Andriustmp/RTKrobot/docs/Project principle diagram.png

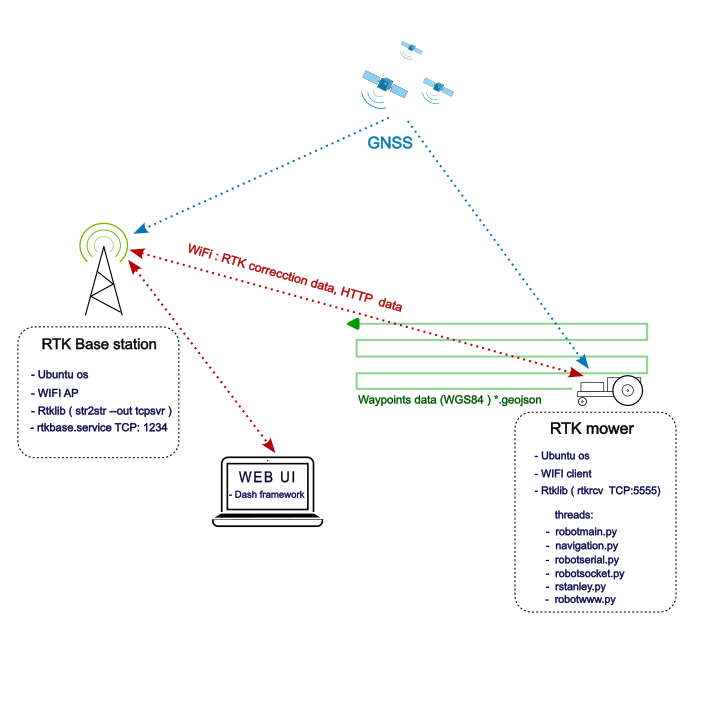
docs/Project principle diagram.png
