Andriustmp/RTKrobot/docs/RTKmower  WebUI.png

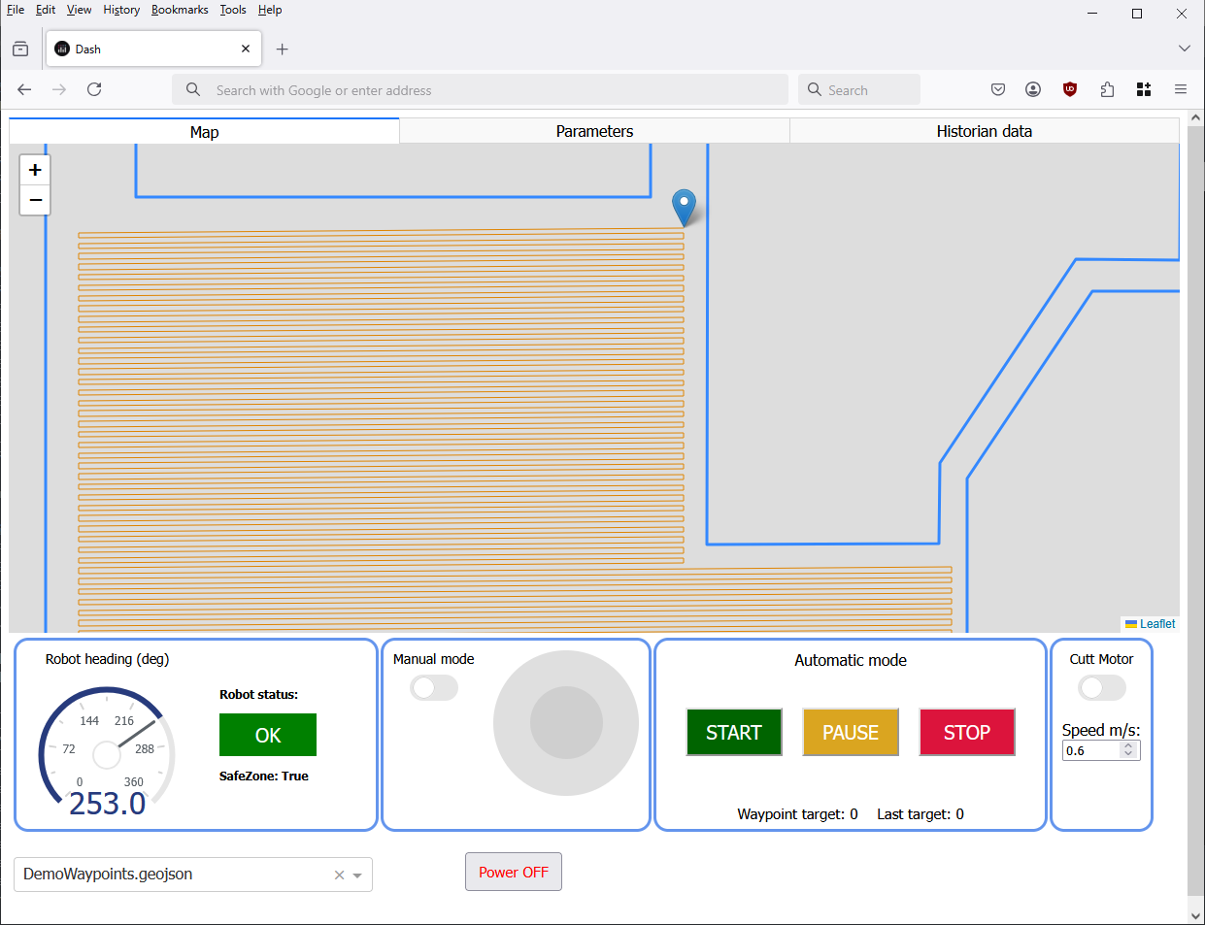
docs/RTKmower WebUI.png
