Andriustmp/RTKrobot/docs/RTKmower Components.png

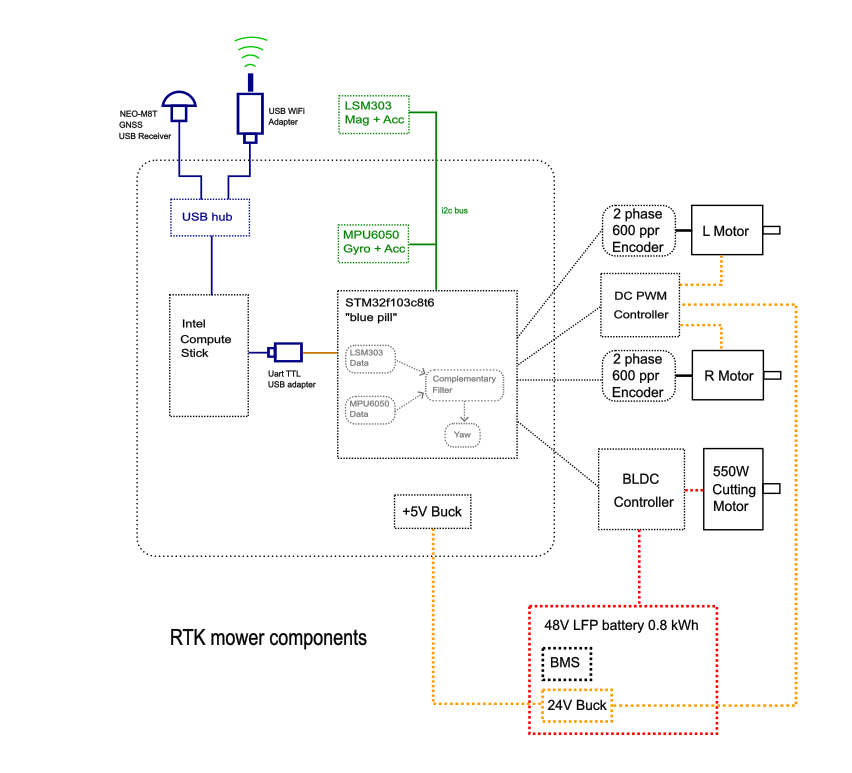
docs/RTKmower Components.png
