Andriustmp/RTKrobot/docs/Debug data sample.png

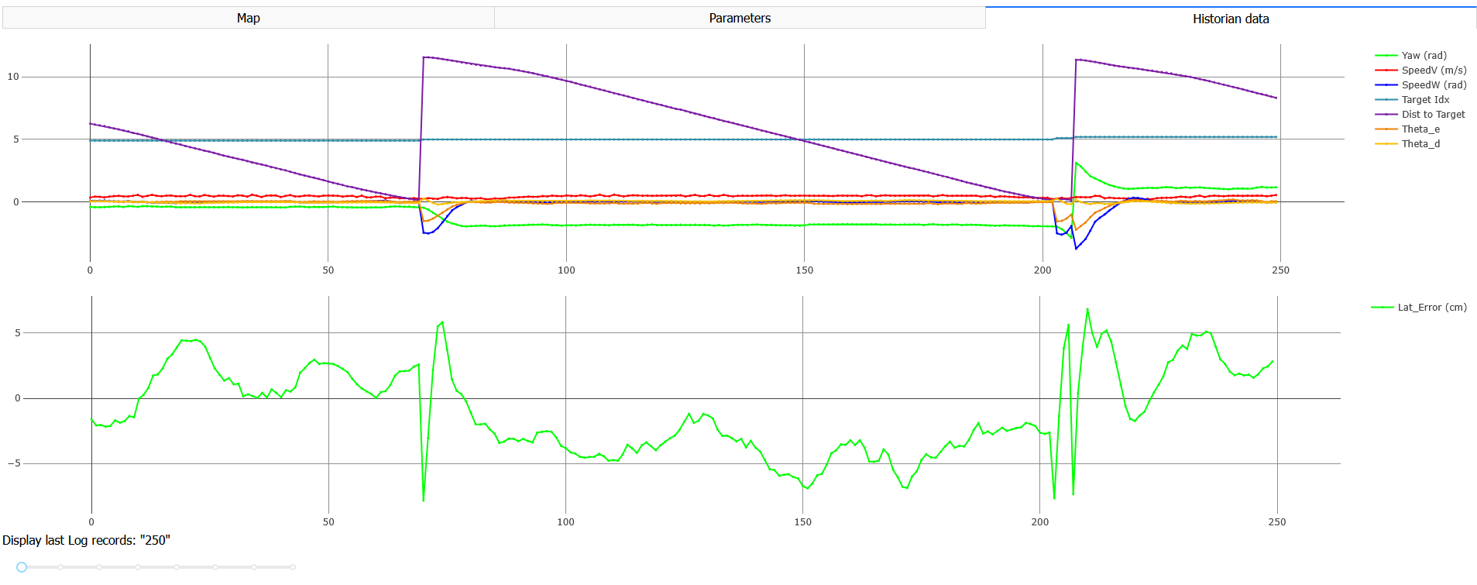
docs/Debug data sample.png
