Andriustmp/RTKrobot/docs/Circuit schematic.pdf

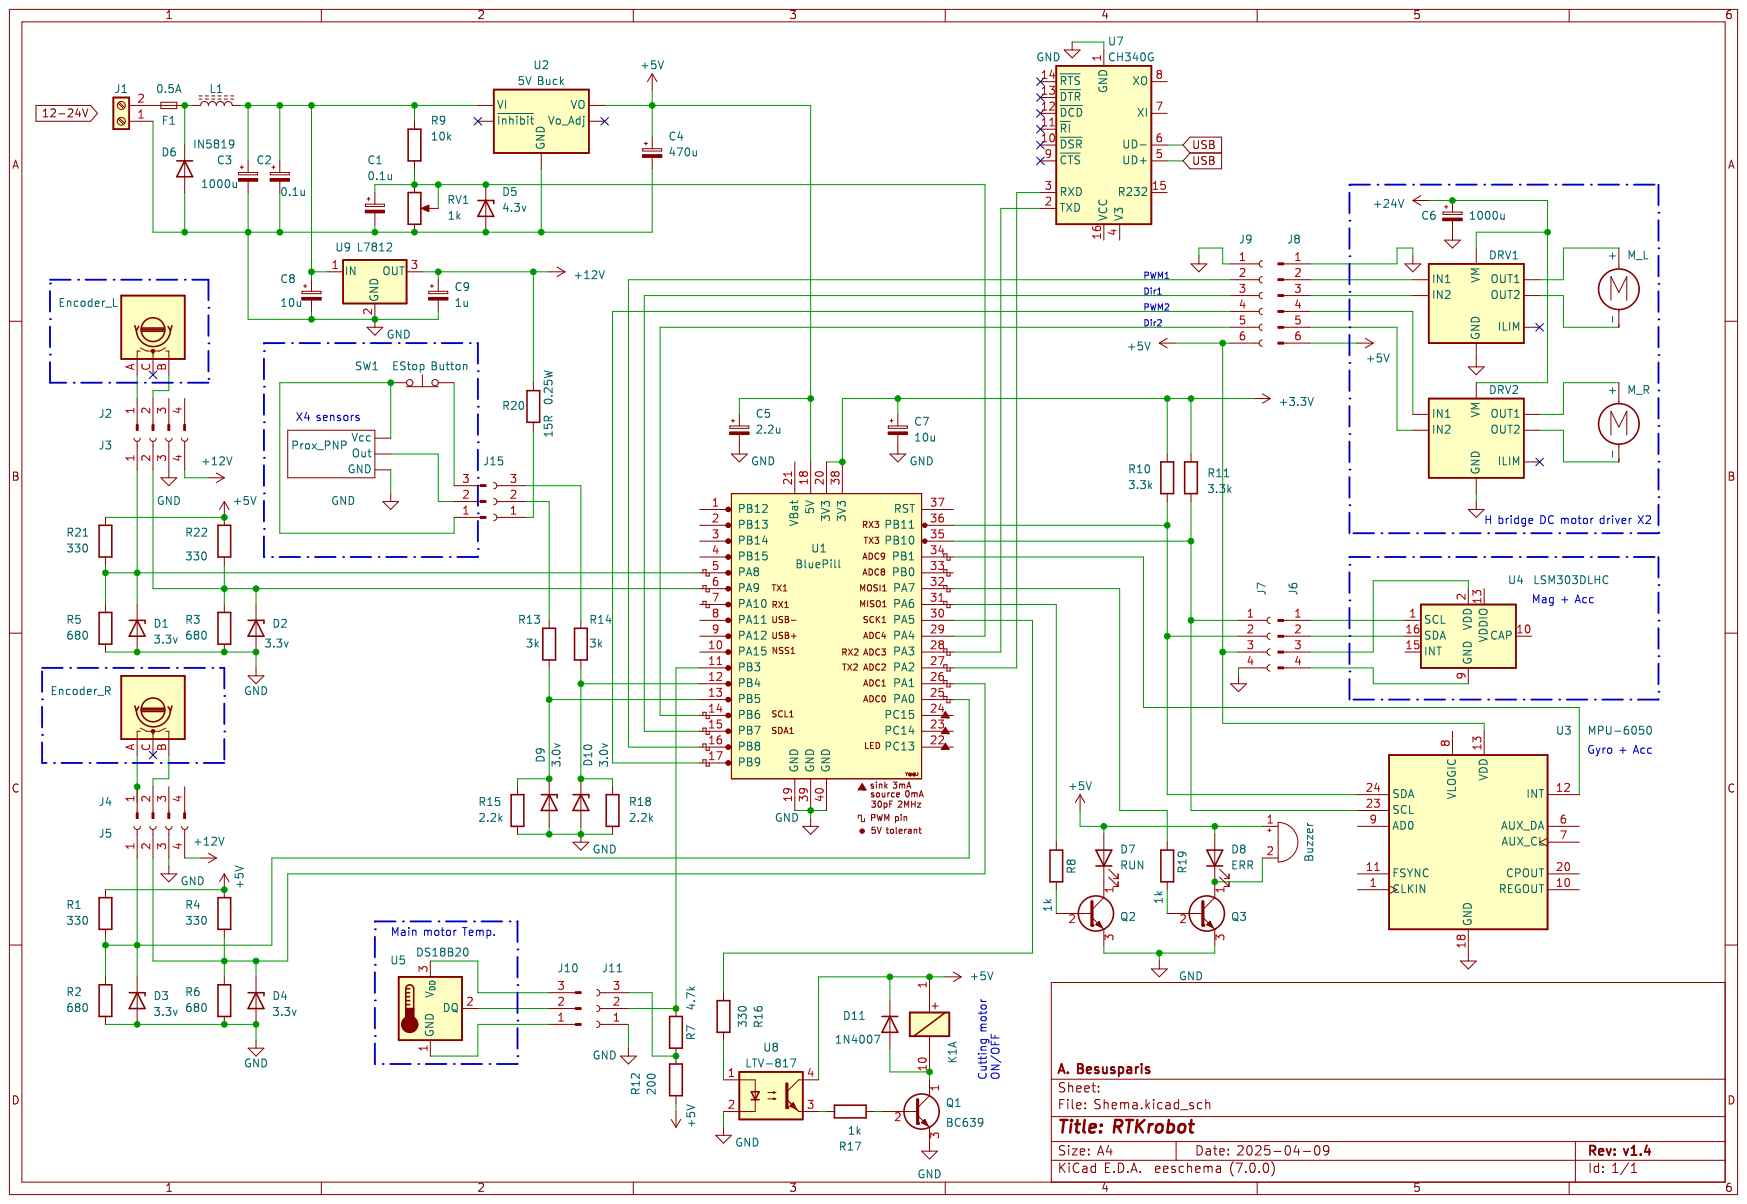
[picture p6: page 1]
