Andriustmp/RTKrobot/RTK mower/Hardware/Customized LSM303 lib/DFRobot_LSM303.cpp

/*!
 * @file DFRobot_LSM303.cpp
 * @brief Define the basic structure of class DFRobot_LSM303 
 * @details By a simple mechanical structure with the sensor, that can be read to the mass of the body
 * @copyright   Copyright (c) 2010 DFRobot Co.Ltd (http://www.dfrobot.com)
 * @License     The MIT License (MIT)
 * @author [fengli](li.feng@dfrobot.com)
 * @version  V1.0
 * @date  2022-05-05
 * @https://github.com/DFRobot/DFRobot_LSM303
 */
 
#include <DFRobot_LSM303.h>
#include <Wire.h>
#include <math.h>

DFRobot_LSM303::DFRobot_LSM303(TwoWire* p_wire)
{
  /*
  These values lead to an assumed magnetometer bias of 0.
  Use the Calibrate example program to determine appropriate values
  for your particular unit. The Heading example demonstrates how to
  adjust these values in your own sketch.
  */
  
  this->p_wire = p_wire;  //--- pridedam
  
  p_wire->begin();
   
  // magnetometer_min = (DFRobot_LSM303::vector<int16_t>){-659, -725, -598};
  // magnetometer_max = (DFRobot_LSM303::vector<int16_t>){+523, +442, +472};
  
  magnetometer_min = (DFRobot_LSM303::vector<int16_t>){0, 0, 0};
  magnetometer_max = (DFRobot_LSM303::vector<int16_t>){0, 0, 0};
  

  _device = device_auto;
  io_timeout = 0;  ///< 0 = no timeout
  did_timeout = false;
}

void DFRobot_LSM303::setMagOffset(float x, float y, float z)
{
  mag_x_offset= x;
  mag_y_offset= y;
  mag_z_offset= z;
}

///< Did a timeout occur in readAcc(), readMag(), or read() since the last call to timeoutOccurred()?
bool DFRobot_LSM303::timeoutOccurred()
{
  bool tmp = did_timeout;
  did_timeout = false;
  return tmp;
}

void DFRobot_LSM303::setTimeout(unsigned int timeout)
{
  io_timeout = timeout;
}

unsigned int DFRobot_LSM303::getTimeout()
{
  return io_timeout;
}

bool DFRobot_LSM303::init(eDeviceType_t device, eSa0State_t sa0)
{
  ///< perform auto-detection unless device type and SA0 state were both specified
  if (device == device_auto || sa0 == sa0_auto)
  {
    ///< check for LSM303D if device is unidentified or was specified to be this type
    if (device == device_auto || device == device_D)
    {
      ///< check SA0 high address unless SA0 was specified to be low
      if (sa0 != sa0_low && myReadReg(D_SA0_HIGH_ADDRESS, WHO_AM_I) == D_WHO_ID)
      {
        ///< device responds to address 0011101 with D ID; it's a D with SA0 high
        device = device_D;
        sa0 = sa0_high;
      }
      ///< check SA0 low address unless SA0 was specified to be high
      else if (sa0 != sa0_high && myReadReg(D_SA0_LOW_ADDRESS, WHO_AM_I) == D_WHO_ID)
      {
        ///< device responds to address 0011110 with D ID; it's a D with SA0 low
        device = device_D;
        sa0 = sa0_low;
      }
    }
    
    ///< check for LSM303DLHC, DLM, DLH if device is still unidentified or was specified to be one of these types
    if (device == device_auto || device == device_DLHC || device == device_DLM || device == device_DLH)
    {
      ///< check SA0 high address unless SA0 was specified to be low
      if (sa0 != sa0_low && myReadReg(DLHC_DLM_DLH_ACC_SA0_HIGH_ADDRESS, CTRL_REG1_A) != TEST_REG_ERROR)
      {
        ///< device responds to address 0011001; it's a DLHC, DLM with SA0 high, or DLH with SA0 high
        sa0 = sa0_high;
        if (device == device_auto)
        { 
          ///< use magnetometer WHO_AM_I register to determine device type
          ///<
          ///< DLHC seems to respond to WHO_AM_I request the same way as DLM, even though this
          ///< register isn't documented in its datasheet. Since the DLHC accelerometer address is the
          ///< same as the DLM with SA0 high, but Pololu DLM boards pull SA0 low by default, we'll
          ///< guess that a device whose accelerometer responds to the SA0 high address and whose
          ///< magnetometer gives the DLM ID is actually a DLHC.
          device = (myReadReg(DLHC_DLM_DLH_MAG_ADDRESS, WHO_AM_I_M) == DLM_WHO_ID) ? device_DLHC : device_DLH;
        }
      }
      ///< check SA0 low address unless SA0 was specified to be high
      else if (sa0 != sa0_high && myReadReg(DLM_DLH_ACC_SA0_LOW_ADDRESS, CTRL_REG1_A) != TEST_REG_ERROR)
      {
        ///< device responds to address 0011000; it's a DLM with SA0 low or DLH with SA0 low
        sa0 = sa0_low;
        if (device == device_auto)
        {
          ///< use magnetometer WHO_AM_I register to determine device type
          device = (myReadReg(DLHC_DLM_DLH_MAG_ADDRESS, WHO_AM_I_M) == DLM_WHO_ID) ? device_DLM : device_DLH;
        }
      }
    }
    
    ///< make sure device and SA0 were successfully detected; otherwise, indicate failure
    if (device == device_auto || sa0 == sa0_auto)
    {
      return false;
    }
  }
  
  _device = device;
  
  ///< set device addresses and translated register addresses
  switch (device)
  {
    case device_D:
      acc_address = mag_address = (sa0 == sa0_high) ? D_SA0_HIGH_ADDRESS : D_SA0_LOW_ADDRESS;
      translated_regs[-OUT_X_L_M] = D_OUT_X_L_M;
      translated_regs[-OUT_X_H_M] = D_OUT_X_H_M;
      translated_regs[-OUT_Y_L_M] = D_OUT_Y_L_M;
      translated_regs[-OUT_Y_H_M] = D_OUT_Y_H_M;
      translated_regs[-OUT_Z_L_M] = D_OUT_Z_L_M;
      translated_regs[-OUT_Z_H_M] = D_OUT_Z_H_M;
      break;

    case device_DLHC:
      acc_address = DLHC_DLM_DLH_ACC_SA0_HIGH_ADDRESS; ///< DLHC doesn't have configurable SA0 but uses same acc address as DLM/DLH with SA0 high
      mag_address = DLHC_DLM_DLH_MAG_ADDRESS;
      translated_regs[-OUT_X_H_M] = DLHC_OUT_X_H_M;
      translated_regs[-OUT_X_L_M] = DLHC_OUT_X_L_M;
      translated_regs[-OUT_Y_H_M] = DLHC_OUT_Y_H_M;
      translated_regs[-OUT_Y_L_M] = DLHC_OUT_Y_L_M;
      translated_regs[-OUT_Z_H_M] = DLHC_OUT_Z_H_M;
      translated_regs[-OUT_Z_L_M] = DLHC_OUT_Z_L_M;
      break;

    case device_DLM:
      acc_address = (sa0 == sa0_high) ? DLHC_DLM_DLH_ACC_SA0_HIGH_ADDRESS : DLM_DLH_ACC_SA0_LOW_ADDRESS;
      mag_address = DLHC_DLM_DLH_MAG_ADDRESS;
      translated_regs[-OUT_X_H_M] = DLM_OUT_X_H_M;
      translated_regs[-OUT_X_L_M] = DLM_OUT_X_L_M;
      translated_regs[-OUT_Y_H_M] = DLM_OUT_Y_H_M;
      translated_regs[-OUT_Y_L_M] = DLM_OUT_Y_L_M;
      translated_regs[-OUT_Z_H_M] = DLM_OUT_Z_H_M;
      translated_regs[-OUT_Z_L_M] = DLM_OUT_Z_L_M;
      break;

    case device_DLH:
      acc_address = (sa0 == sa0_high) ? DLHC_DLM_DLH_ACC_SA0_HIGH_ADDRESS : DLM_DLH_ACC_SA0_LOW_ADDRESS;
      mag_address = DLHC_DLM_DLH_MAG_ADDRESS;
      translated_regs[-OUT_X_H_M] = DLH_OUT_X_H_M;
      translated_regs[-OUT_X_L_M] = DLH_OUT_X_L_M;
      translated_regs[-OUT_Y_H_M] = DLH_OUT_Y_H_M;
      translated_regs[-OUT_Y_L_M] = DLH_OUT_Y_L_M;
      translated_regs[-OUT_Z_H_M] = DLH_OUT_Z_H_M;
      translated_regs[-OUT_Z_L_M] = DLH_OUT_Z_L_M;
      break;
  }
  //Serial2.println("devaisas:");  // DLHC device !
  // Serial2.println(mag_address);
  
  
  return true;
}

void DFRobot_LSM303::enable(void)
{

  if (_device == device_D)
  {
    ///< Accelerometer

    ///< 0x00 = 0b00000000
    ///< AFS = 0 (+/- 2 g full scale)
    writeReg(CTRL2, 0x00);
    ///< 0x57 = 0b01010111
    ///< AODR = 0101 (50 Hz ODR); AZEN = AYEN = AXEN = 1 (all axes enabled)
	// 
    writeReg(CTRL1, 0x57);
    ///< Magnetometer
    ///< 0x64 = 0b01100100
    ///< M_RES = 11 (high resolution mode); M_ODR = 001 (6.25 Hz ODR)
    writeReg(CTRL5, 0x64);
    ///< 0x20 = 0b00100000
    ///< MFS = 01 (+/- 4 gauss full scale)
    writeReg(CTRL6, 0x20);
    ///< 0x00 = 0b00000000
    ///< MLP = 0 (low power mode off); MD = 00 (continuous-conversion mode)
    writeReg(CTRL7, 0x00);
  }
  else
  {
    /// -------- Accelerometer  model used  ------
    if (_device == device_DLHC)
    {
      ///< 0x08 = 0b00001000 2g
      ///< FS = 00 (+/- 2 g full scale); HR = 1 (high resolution enable)
	  // 0x18  = +- 4g 
	  // FS +- 16g 0x38

      writeAccReg(CTRL_REG4_A, 0x08); // 0x28 - 8g
      ///< 0x47 = 0b01000111
      ///< ODR = 0100 (50 Hz ODR); LPen = 0 (normal mode); Zen = Yen = Xen = 1 (all axes enabled)
	  
      writeAccReg(CTRL_REG1_A, 0x77);  // 400 hz = 0x77; 50Hz =0x47 
	  // - filtras
	  // FDS on- 0x08
	  writeAccReg(CTRL_REG2_A, 0x00);
	  
    }
    else ///< DLM, DLH
    {
      ///< 0x00 = 0b00000000
      ///< FS = 00 (+/- 2 g full scale)
      writeAccReg(CTRL_REG4_A, 0x00);
      ///< 0x27 = 0b00100111
      ///< PM = 001 (normal mode); DR = 00 (50 Hz ODR); Zen = Yen = Xen = 1 (all axes enabled)
      writeAccReg(CTRL_REG1_A, 0x27);
    }

    ///< Magnetometer

    ///< 0x0C = 0b00001100  7.5 hz
    ///< DO = 011 (7.5 Hz ODR)
	// 15 hz = 0x10
    writeMagReg(CRA_REG_M, 0x0C);

    ///< 0x20 = 0b00100000 
    ///< GN = 001 
    writeMagReg(CRB_REG_M, 0x20);   // (+/- 1.3 gauss full scale)

    ///< 0x00 = 0b00000000
    ///< MD = 00 (continuous-conversion mode)
    writeMagReg(MR_REG_M, 0x00);
  }
}

///< Writes an accelerometer register
void DFRobot_LSM303::writeAccReg(byte reg, byte value)
{
  p_wire->beginTransmission(acc_address);
  p_wire->write(reg);
  p_wire->write(value);
  last_status = p_wire->endTransmission();
}

///< Reads an accelerometer register
byte DFRobot_LSM303::readAccReg(byte reg)
{
  byte value;
  p_wire->beginTransmission(acc_address);
  p_wire->write(reg);
  last_status = p_wire->endTransmission();
  p_wire->requestFrom(acc_address, (byte)1);
  value = p_wire->read();
  p_wire->endTransmission();
  return value;
}

///< Writes a magnetometer register
void DFRobot_LSM303::writeMagReg(byte reg, byte value)
{
  p_wire->beginTransmission(mag_address);
  p_wire->write(reg);
  p_wire->write(value);
  last_status = p_wire->endTransmission();
}

///< Reads a magnetometer register
byte DFRobot_LSM303::readMagReg(int reg)
{
  byte value;

  ///< if dummy register address (magnetometer Y/Z), look up actual translated address (based on device type)
  if (reg < 0)
  {
    reg = translated_regs[-reg];
  }

  p_wire->beginTransmission(mag_address);
  p_wire->write(reg);
  last_status = p_wire->endTransmission();
  p_wire->requestFrom(mag_address, (byte)1);
  value = p_wire->read();
  p_wire->endTransmission();

  return value;
}

void DFRobot_LSM303::writeReg(byte reg, byte value)
{
  ///< mag address == acc_address for LSM303D, so it doesn't really matter which one we use.
  if (_device == device_D || reg < CTRL_REG1_A)
  {
    writeMagReg(reg, value);
  }
  else
  {
    writeAccReg(reg, value);
  }
}

///< Note that this function will not work for reading TEMP_OUT_H_M and TEMP_OUT_L_M on the DLHC.
///< To read those two registers, use readMagReg() instead.
byte DFRobot_LSM303::readReg(int reg)
{
  ///< mag address == acc_address for LSM303D, so it doesn't really matter which one we use.
  ///< Use readMagReg so it can translate OUT_[XYZ]_[HL]_M
  if (_device == device_D || reg < CTRL_REG1_A)
  {
    return readMagReg(reg);
  }
  else
  {
    return readAccReg(reg);
  }
}
//--------------------------------------------------------------------------

int i=0;
int i2=0;
int i3=0;
const int size=45;       // 45
const int reject_val=500;
long totalx;
long totaly;
long totalz;
int16_t arrayx[size];
int16_t arrayy[size];	
int16_t arrayz[size];		

float DFRobot_LSM303::MovAverageX(int16_t new_value)
{ 
/*
  int diff = accelerometer.x-new_value;
  int diff_abs=abs(diff);
  
  if (diff_abs>reject_val) 
	  new_value=new_value+diff;
	*/  
  totalx -= arrayx[i];             
  arrayx[i] = new_value; 
  totalx += new_value;  
  i = (i+1) % size;     
  return (float) totalx / size;    	
}

float DFRobot_LSM303::MovAverageY(int16_t new_value)
{
/*	
  int diff = accelerometer.y-new_value;
  int diff_abs=abs(diff);
  
  if (diff_abs>reject_val) 
	  new_value=new_value+diff;
  */
  totaly -= arrayy[i2];
  arrayy[i2] = new_value;    
  totaly += new_value;        
  i2 = (i2+1) % size;                
  return (float) totaly / size;    	
}

float DFRobot_LSM303::MovAverageZ(int16_t new_value)
{
/*	
  int diff = accelerometer.z-new_value;
  int diff_abs=abs(diff);
  
  if (diff_abs>reject_val) 
	  new_value=new_value+diff;
  */
  
  totalz -= arrayz[i3];
  arrayz[i3] = new_value;   
  totalz += new_value;         
  i3 = (i3+1) % size;                
  return (float) totalz / size;    	
}
   
void DFRobot_LSM303::readAcc(void)
{
  p_wire->beginTransmission(acc_address);
  ///< assert the MSB of the address to get the accelerometer
  ///< to do slave-transmit subaddress updating.
  p_wire->write(OUT_X_L_A | (1 << 7));
  last_status = p_wire->endTransmission();
  p_wire->requestFrom(acc_address, (byte)6);

  unsigned int millis_start = millis();
  while (p_wire->available() < 6) 
  {
    if (io_timeout > 0 && ((unsigned int)millis() - millis_start) > io_timeout)
    {
      did_timeout = true;
      return;
    }
  }

  byte xla = p_wire->read();
  byte xha = p_wire->read();
  byte yla = p_wire->read();
  byte yha = p_wire->read();
  byte zla = p_wire->read();
  byte zha = p_wire->read();

  ///< combine high and low bytes
  ///< This no longer drops the lowest 4 bits of the readings from the DLH/DLM/DLHC, which are always 0
  ///< (12-bit resolution, left-aligned). The D has 16-bit resolution
  
  // accelerometer.x = (int16_t)(xha << 8 | xla); 
  // accelerometer.y = (int16_t)(yha << 8 | yla); 
  // accelerometer.z = (int16_t)(zha << 8 | zla); 
  
  // ---------- Modified  ACC read,   LPF + rolling average(45X) ----------
   
   float alfa=0.01; // 
 
   accavg.x =(1-alfa)*accavg.x+(alfa*(int16_t)(xha << 8 | xla));   
   accavg.y =(1-alfa)*accavg.y+(alfa*(int16_t)(yha << 8 | yla));   
   accavg.z =(1-alfa)*accavg.z+(alfa*(int16_t)(zha << 8 | zla));  //  x,y axes dif. from z mechanicly 
    
   int accx_offset=accavg.x+220;                                  // accelerometer axis offsets
   int accy_offset=accavg.y-1500;
   int accz_offset=accavg.z+3500;
      
   accelerometer.x =int(MovAverageX(accx_offset));
   accelerometer.y =int(MovAverageY(accy_offset));
   accelerometer.z =int(MovAverageZ(accz_offset));
   
   /* 
   Serial2.print(accelerometer.x);
   Serial2.print(","); 
   Serial2.print(accelerometer.y);
   Serial2.print(",");
   Serial2.println(accelerometer.z);
   */     
}

///< Reads the 3 magnetometer channels and stores them in vector m
void DFRobot_LSM303::readMag(void)
{
  p_wire->beginTransmission(mag_address);
  ///< If LSM303D, assert MSB to enable subaddress updating
  ///< OUT_X_L_M comes first on D, OUT_X_H_M on others
  p_wire->write((_device == device_D) ? translated_regs[-OUT_X_L_M] | (1 << 7) : translated_regs[-OUT_X_H_M]);
  last_status = p_wire->endTransmission();
  p_wire->requestFrom(mag_address, (byte)6);

  unsigned int millis_start = millis();
  while (p_wire->available() < 6) 
  {
    if (io_timeout > 0 && ((unsigned int)millis() - millis_start) > io_timeout)
    {
      did_timeout = true;
      return;
    }
  }

  byte xlm, xhm, ylm, yhm, zlm, zhm;

  if (_device == device_D)
  {
    ///< D: X_L, X_H, Y_L, Y_H, Z_L, Z_H
    xlm = p_wire->read();
    xhm = p_wire->read();
    ylm = p_wire->read();
    yhm = p_wire->read();
    zlm = p_wire->read();
    zhm = p_wire->read();
  }
  else
  {
    ///< DLHC, DLM, DLH: X_H, X_L...
    xhm = p_wire->read();
    xlm = p_wire->read();

    if (_device == device_DLH)
    {
      ///< DLH: ...Y_H, Y_L, Z_H, Z_L
      yhm = p_wire->read();
      ylm = p_wire->read();
      zhm = p_wire->read();
      zlm = p_wire->read();
    }
    else
    {
      ///< DLM, DLHC: ...Z_H, Z_L, Y_H, Y_L
      zhm = p_wire->read();
      zlm = p_wire->read();
      yhm = p_wire->read();
      ylm = p_wire->read();
    }
  }

  ///< combine high and low bytes
  magnetometer.x = (int16_t)(xhm << 8 | xlm);
  magnetometer.y = (int16_t)(yhm << 8 | ylm);
  magnetometer.z = (int16_t)(zhm << 8 | zlm);
  
  magnetometer.x -= mag_x_offset;     // compass.setMagOffset(-74.2, -207.7, -141.3);
  magnetometer.y -= mag_y_offset;     // 
  magnetometer.z -= mag_z_offset;     // 
  
 /*
  Serial2.print(magnetometer.x);
  Serial2.print(",");
  Serial2.print(magnetometer.y);
  Serial2.print(",");
  Serial2.println(magnetometer.z);
  */
 
}
///< Reads all 6 channels of the DFRobot_LSM303 and stores them in the object variables
void DFRobot_LSM303::read(void)
{
  readAcc();
  readMag();
}

float DFRobot_LSM303::getNavigationAngle(void)
{
  if (_device == device_D)
  {
    return heading((vector<int>){1, 0, 0});
  }
  else
  {
    return heading((vector<int>){0,-1, 0});  //  {0, -1, 0});
  }
}

void DFRobot_LSM303::vectorNormalize(vector<float> *a)
{
  float mag = sqrt(vectorDot(a, a));  // vector magnitude
  a->x /= mag;
  a->y /= mag;
  a->z /= mag;
}

//-----------------------------------------------------------------------------------------------

template <typename T> float DFRobot_LSM303::heading(vector<T> from)
{  
   float alfa = 0.5;
   int   heading_filtered=0;
   float heddif=0;
   
   vector<int32_t> temp_m = {magnetometer.x, magnetometer.y, magnetometer.z};
   
   temp_m.x = magnetometer.x;
   temp_m.y = magnetometer.y;
   temp_m.z = magnetometer.z;

    ///< compute E and N
    vector<float> E;
    vector<float> N;
    vectorCross(&temp_m, &accelerometer, &E);   // The cross product of North and Up vectors is East
    vectorNormalize(&E);
    vectorCross(&accelerometer, &E, &N);
    vectorNormalize(&N);

    ///< compute heading
    float headingnew = atan2(vectorDot(&E, &from), vectorDot(&N, &from)) * 180 / M_PI;
    if (headingnew < 0) headingnew += 360;
	    
	// Serial2.print(accelerometer.x);
	// Serial2.print(",");
	// Serial2.println(headingnew);
	
	heddif=headingold - headingnew;
	
	 if (abs(heddif) <359 )         // 0-360 histerisis
		{
	     headingold=headingnew; 		
		 heading_filtered=int(((1-alfa)*headingold)+(alfa*headingnew));	
		
		}
		 else 
		{ 		 
		 headingold=headingold;
	     heading_filtered=int(((1-alfa)*headingold)+(alfa*headingold));
		} 
		
	//Serial2.println(heading_filtered);
    return heading_filtered;
}

template <typename Ta, typename Tb, typename To> void DFRobot_LSM303::vectorCross(const vector<Ta> *a, const vector<Tb> *b, vector<To> *out)
{
  out->x = (a->y * b->z) - (a->z * b->y);
  out->y = (a->z * b->x) - (a->x * b->z);
  out->z = (a->x * b->y) - (a->y * b->x);
}

template <typename Ta, typename Tb> float DFRobot_LSM303::vectorDot(const vector<Ta> *a, const vector<Tb> *b)
{
  return (a->x * b->x) + (a->y * b->y) + (a->z * b->z);
}

int DFRobot_LSM303::myReadReg(byte address, eRegAddr_t reg)
{
  p_wire->beginTransmission(address);
  p_wire->write((byte)reg);
  if (p_wire->endTransmission() != 0)
  {
    return TEST_REG_ERROR;
  }

  p_wire->requestFrom(address, (byte)1);
  if (p_wire->available())
  {
    return p_wire->read();
  }
  else
  {
    return TEST_REG_ERROR;
  }
}
